JIRENGOD/Digital-Synthesizer-Keyboard-with-Multiple-Voices/docs/images/fig1_design_flow.png

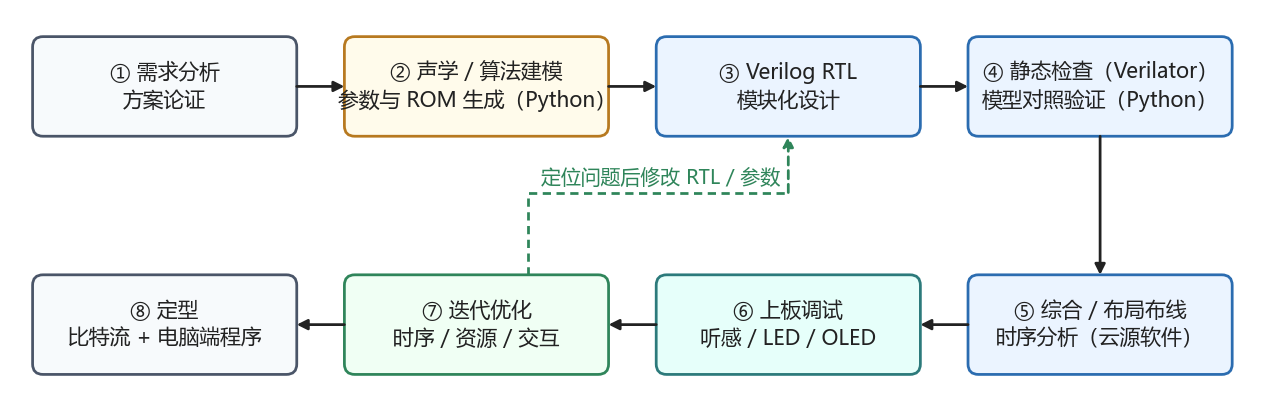
docs/images/fig1_design_flow.png
