JIRENGOD/Digital-Synthesizer-Keyboard-with-Multiple-Voices/docs/images/fig2_hierarchy.png

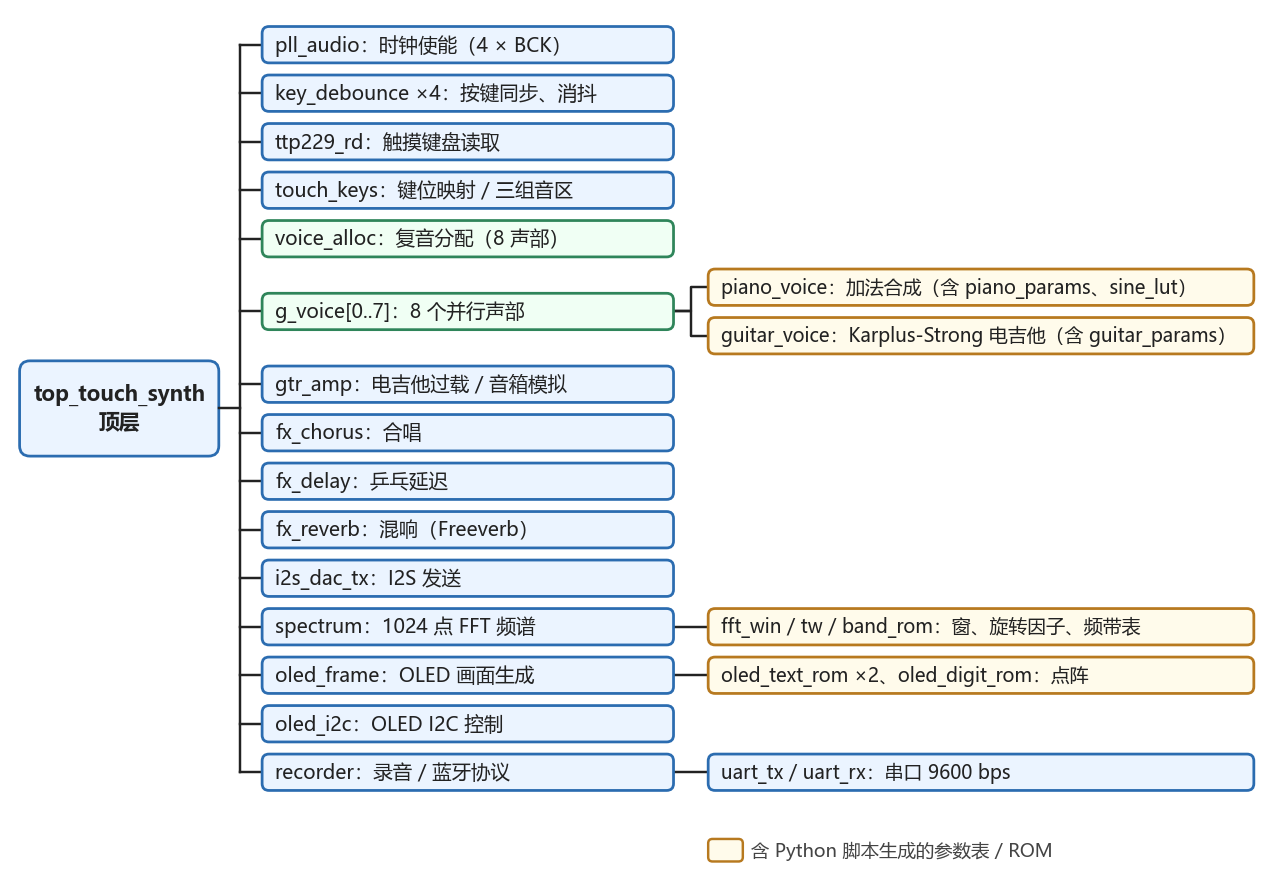
docs/images/fig2_hierarchy.png
