JIRENGOD/Digital-Synthesizer-Keyboard-with-Multiple-Voices/docs/images/fig2_oled.png

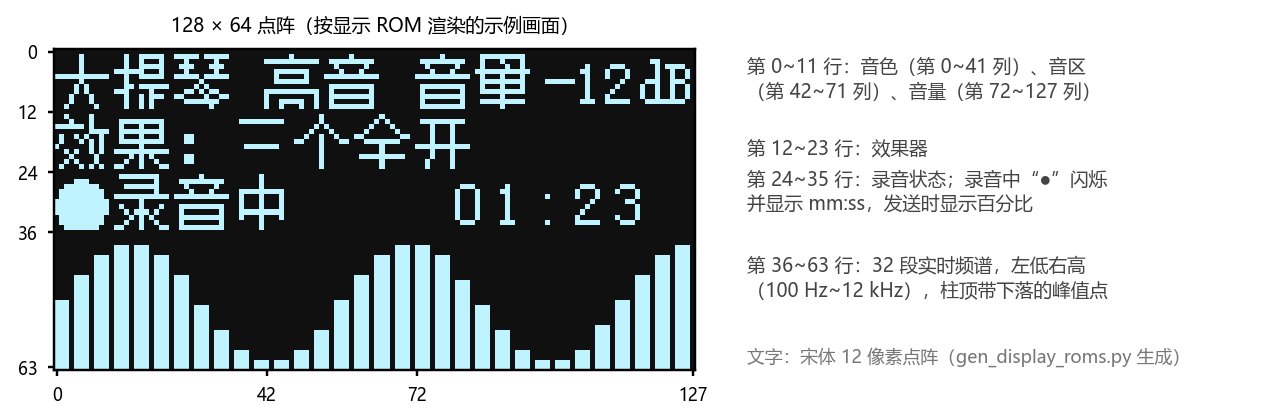
docs/images/fig2_oled.png
