JIRENGOD/Digital-Synthesizer-Keyboard-with-Multiple-Voices/docs/images/fig3_demo_render.png

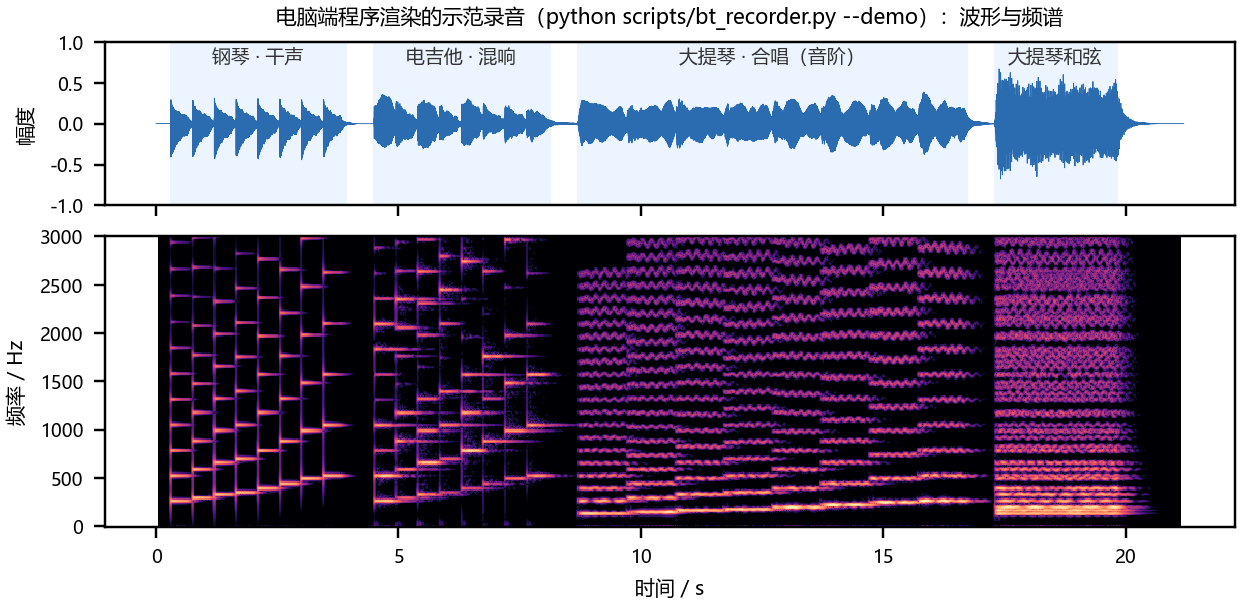
docs/images/fig3_demo_render.png
