JIRENGOD/Digital-Synthesizer-Keyboard-with-Multiple-Voices/src/piano/piano_params.v

`timescale 1ns/1ps
// =============================================================================
// piano_params.v —— 加法合成音色参数表：音色 0 = 钢琴（A2 ~ F#6），音色 1 = 大提琴（A1 ~ F#5）
// 由 scripts/gen_piano_params.py 自动生成。不要手改下面的数字：改音色请改脚本顶部的“音色旋钮”，
// 然后重新生成。
// -----------------------------------------------------------------------------
// 音序号 note = 0 ~ 45：钢琴 MIDI 45 + note，大提琴 MIDI 33 + note（低一个八度）
// 每个振荡器（一个正弦分音）的参数，piano_voice.v 每个采样依次计算全部振荡器再相加：
//   base  基音相位增量 = round(基音频率 × 2^32 / 48828.1)，按 {音色, 音} 查表
//   ratio 频率倍数（Q5.20，噪声为 0），按 {音色, 振荡器} 查表；相位增量 = base × ratio
//   peak  包络峰值（24 位，满幅 16777215）；每个音所有振荡器的 peak 之和 = 0.9 满幅，不会削顶
//   att   起音：每个采样包络加 att，直到 peak（线性上升）
//   m1    衰减 1：每 m1 个采样，包络 ×(1-1/256)，即 -0.0339 dB
//   knee  包络低于 knee 后切换到衰减 2
//   m2    衰减 2：同 m1
//   抬键（note_off）后改用 m_rel 衰减
// peak、att、knee：钢琴按振荡器查表（与音高无关）；大提琴按 {音, 振荡器} 查表（随音高变，放在 BSRAM 里）
// 除 m_rel、noise_lpf 外，所有输出都晚 1 拍（输出寄存）。
//
// 音色 0：钢琴（抬键 118.6 dB/s，噪声低通 >>2）
//  序号 振荡器        频率倍数  电平(dB)  起音(ms)  衰减1(dB/s)  拐点(dB)  衰减2(dB/s)
//    0  第1分音          1.0000      0.0     2.00        12.0       -12         3.4
//    1  第2分音          2.0010     -1.0     1.41        22.4       -12         6.4
//    2  第3分音          3.0042     -4.0     1.15        32.5       -12         9.2
//    3  第4分音          4.0105     -6.0     1.00        41.5       -12        11.9
//    4  第5分音          5.0209     -8.0     0.89        51.9       -12        14.6
//    5  第6分音          6.0366    -10.0     0.82        59.3       -12        17.1
//    6  第7分音          7.0585    -13.0     0.76        69.2       -12        19.8
//    7  第8分音          8.0877    -24.0     0.71        79.0       -12        22.1
//    8  第9分音          9.1251    -16.0     0.67        87.4       -12        24.8
//    9  第10分音        10.1717    -18.0     0.63        97.6       -12        27.2
//   10  第11分音        11.2285    -21.0     0.60       103.7       -12        29.6
//   11  第12分音        12.2965    -23.0     0.58       110.7       -12        31.9
//   12  第13分音        13.3766    -26.0     0.55       118.6       -12        34.6
//   13  第14分音        14.4697    -29.0     0.53       127.7       -12        36.9
//   14  第15分音        15.5767    -32.0     0.52       138.3       -12        39.5
//   15  第16分音        16.6985    -42.0     0.50       150.9       -12        41.5
//   16  第1分音失谐弦    1.0009      0.0     2.00        12.0       -12         3.4
//   17  第2分音失谐弦    2.0029     -1.0     1.41        22.4       -12         6.4
//   18  第3分音失谐弦    3.0070     -4.0     1.15        32.5       -12         9.2
//   19  第4分音失谐弦    4.0142     -6.0     1.00        41.5       -12        11.9
//   20  琴槌噪声           噪声    -18.4     0.50      1659.9       -20       415.0
//
// 音色 1：大提琴（抬键 59.3 dB/s，噪声低通 >>1）（电平是音序号 23 = G#3 的）
//  序号 振荡器        频率倍数  电平(dB)  起音(ms)  衰减1(dB/s)  拐点(dB)  衰减2(dB/s)
//    0  第1谐波          1.0000      0.0    90.00         6.0        -2         0.4
//    1  第2谐波          2.0000     -8.2    73.10         6.0        -2         0.4
//    2  第3谐波          3.0000    -14.4    64.73         6.0        -2         0.4
//    3  第4谐波          4.0000    -19.0    59.38         6.0        -2         0.4
//    4  第5谐波          5.0000    -21.8    55.53         6.0        -2         0.4
//    5  第6谐波          6.0000    -22.7    52.58         6.0        -2         0.4
//    6  第7谐波          7.0000    -22.5    50.20         6.0        -2         0.4
//    7  第8谐波          8.0000    -22.2    48.23         6.0        -2         0.4
//    8  第9谐波          9.0000    -22.2    46.56         6.0        -2         0.4
//    9  第10谐波        10.0000    -22.6    45.11         6.0        -2         0.4
//   10  第11谐波        11.0000    -23.2    43.84         6.0        -2         0.4
//   11  第12谐波        12.0000    -23.9    42.71         6.0        -2         0.4
//   12  第13谐波        13.0000    -24.8    41.69         6.0        -2         0.4
//   13  第14谐波        14.0000    -25.7    40.78         6.0        -2         0.4
//   14  第15谐波        15.0000    -27.2    39.94         6.0        -2         0.4
//   15  第16谐波        16.0000    -29.2    39.17         6.0        -2         0.4
//   16  第17谐波        17.0000    -31.1    38.47         6.0        -2         0.4
//   17  第18谐波        18.0000    -32.8    37.81         6.0        -2         0.4
//   18  第19谐波        19.0000    -34.5    37.21         6.0        -2         0.4
//   19  第20谐波        20.0000    -36.0    36.64         6.0        -2         0.4
//   20  弓毛噪声           噪声    -24.0     8.00        59.3       -12         0.4
// =============================================================================
module piano_params (
    input  wire        clk,
    input  wire        patch,      // 音色：0 = 钢琴，1 = 大提琴
    input  wire [5:0]  note,       // 音序号 0 ~ 45
    input  wire [4:0]  idx,        // 振荡器序号
    output reg  [26:0] base,       // 基音相位增量
    output reg  [24:0] ratio,      // 频率倍数 Q5.20
    output wire [23:0] peak,       // 包络峰值
    output wire [23:0] att,        // 起音每采样增量
    output wire [23:0] knee,       // 衰减 1 -> 衰减 2 的拐点
    output reg  [11:0] m1,         // 衰减 1 周期（采样数）
    output reg  [11:0] m2,         // 衰减 2 周期（采样数）
    output reg         is_noise,   // 1 = 噪声（不查正弦表）
    output reg         is_last,    // 1 = 最后一个振荡器
    output wire [11:0] m_rel,      // 抬键后的衰减周期（组合输出）
    output wire [3:0]  noise_lpf   // 噪声一阶低通的右移位数（组合输出）
);

    assign m_rel     = patch ? 12'd28 : 12'd14;   // 大提琴 59.3 dB/s，钢琴 118.6 dB/s
    assign noise_lpf = patch ? 4'd1 : 4'd2;

    reg        patch_q;
    reg [71:0] pia_q;              // 钢琴 {peak, att, knee}
    reg [71:0] cel_q;              // 大提琴 {peak, att, knee}
    assign {peak, att, knee} = patch_q ? cel_q : pia_q;

    always @(posedge clk) begin
        patch_q <= patch;

        // 基音相位增量：按 {音色, 音序号} 查表
        case ({patch, note})
        {1'b0, 6'd0 }: base <= 27'd9675702;    // 钢琴 A2    110.00 Hz
        {1'b0, 6'd1 }: base <= 27'd10251050;   // 钢琴 A#2   116.54 Hz
        {1'b0, 6'd2 }: base <= 27'd10860609;   // 钢琴 B2    123.47 Hz
        {1'b0, 6'd3 }: base <= 27'd11506414;   // 钢琴 C3    130.81 Hz
        {1'b0, 6'd4 }: base <= 27'd12190621;   // 钢琴 C#3   138.59 Hz
        {1'b0, 6'd5 }: base <= 27'd12915513;   // 钢琴 D3    146.83 Hz
        {1'b0, 6'd6 }: base <= 27'd13683509;   // 钢琴 D#3   155.56 Hz
        {1'b0, 6'd7 }: base <= 27'd14497173;   // 钢琴 E3    164.81 Hz
        {1'b0, 6'd8 }: base <= 27'd15359220;   // 钢琴 F3    174.61 Hz
        {1'b0, 6'd9 }: base <= 27'd16272527;   // 钢琴 F#3   185.00 Hz
        {1'b0, 6'd10}: base <= 27'd17240142;   // 钢琴 G3    196.00 Hz
        {1'b0, 6'd11}: base <= 27'd18265294;   // 钢琴 G#3   207.65 Hz
        {1'b0, 6'd12}: base <= 27'd19351405;   // 钢琴 A3    220.00 Hz
        {1'b0, 6'd13}: base <= 27'd20502099;   // 钢琴 A#3   233.08 Hz
        {1'b0, 6'd14}: base <= 27'd21721217;   // 钢琴 B3    246.94 Hz
        {1'b0, 6'd15}: base <= 27'd23012828;   // 钢琴 C4    261.63 Hz
        {1'b0, 6'd16}: base <= 27'd24381242;   // 钢琴 C#4   277.18 Hz
        {1'b0, 6'd17}: base <= 27'd25831026;   // 钢琴 D4    293.66 Hz
        {1'b0, 6'd18}: base <= 27'd27367019;   // 钢琴 D#4   311.13 Hz
        {1'b0, 6'd19}: base <= 27'd28994347;   // 钢琴 E4    329.63 Hz
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
        {1'b1, 6'd34}: base <= 27'd34480283;   // 大提琴 G4    392.00 Hz
        {1'b1, 6'd35}: base <= 27'd36530588;   // 大提琴 G#4   415.30 Hz
        {1'b1, 6'd36}: base <= 27'd38702809;   // 大提琴 A4    440.00 Hz
        {1'b1, 6'd37}: base <= 27'd41004198;   // 大提琴 A#4   466.16 Hz
        {1'b1, 6'd38}: base <= 27'd43442435;   // 大提琴 B4    493.88 Hz
        {1'b1, 6'd39}: base <= 27'd46025656;   // 大提琴 C5    523.25 Hz
        {1'b1, 6'd40}: base <= 27'd48762484;   // 大提琴 C#5   554.37 Hz
        {1'b1, 6'd41}: base <= 27'd51662052;   // 大提琴 D5    587.33 Hz
        {1'b1, 6'd42}: base <= 27'd54734038;   // 大提琴 D#5   622.25 Hz
        {1'b1, 6'd43}: base <= 27'd57988693;   // 大提琴 E5    659.26 Hz
        {1'b1, 6'd44}: base <= 27'd61436880;   // 大提琴 F5    698.46 Hz
        {1'b1, 6'd45}: base <= 27'd65090107;   // 大提琴 F#5   739.99 Hz
        default: base <= 27'd0;
        endcase

        // 频率倍数、衰减周期、噪声标志：按 {音色, 振荡器序号} 查表
        case ({patch, idx})
        {1'b0, 5'd0 }: begin ratio <= 25'd1048576;  m1 <= 12'd138;  m2 <= 12'd484;  is_noise <= 1'b0; is_last <= 1'b0; end  // 钢琴 第1分音
        {1'b0, 5'd1 }: begin ratio <= 25'd2098252;  m1 <= 12'd74;   m2 <= 12'd259;  is_noise <= 1'b0; is_last <= 1'b0; end  // 钢琴 第2分音
        {1'b0, 5'd2 }: begin ratio <= 25'd3150127;  m1 <= 12'd51;   m2 <= 12'd180;  is_noise <= 1'b0; is_last <= 1'b0; end  // 钢琴 第3分音
        {1'b0, 5'd3 }: begin ratio <= 25'd4205296;  m1 <= 12'd40;   m2 <= 12'd139;  is_noise <= 1'b0; is_last <= 1'b0; end  // 钢琴 第4分音
        {1'b0, 5'd4 }: begin ratio <= 25'd5264846;  m1 <= 12'd32;   m2 <= 12'd114;  is_noise <= 1'b0; is_last <= 1'b0; end  // 钢琴 第5分音
        {1'b0, 5'd5 }: begin ratio <= 25'd6329860;  m1 <= 12'd28;   m2 <= 12'd97;   is_noise <= 1'b0; is_last <= 1'b0; end  // 钢琴 第6分音
        {1'b0, 5'd6 }: begin ratio <= 25'd7401410;  m1 <= 12'd24;   m2 <= 12'd84;   is_noise <= 1'b0; is_last <= 1'b0; end  // 钢琴 第7分音
        {1'b0, 5'd7 }: begin ratio <= 25'd8480556;  m1 <= 12'd21;   m2 <= 12'd75;   is_noise <= 1'b0; is_last <= 1'b0; end  // 钢琴 第8分音
        {1'b0, 5'd8 }: begin ratio <= 25'd9568347;  m1 <= 12'd19;   m2 <= 12'd67;   is_noise <= 1'b0; is_last <= 1'b0; end  // 钢琴 第9分音
        {1'b0, 5'd9 }: begin ratio <= 25'd10665816; m1 <= 12'd17;   m2 <= 12'd61;   is_noise <= 1'b0; is_last <= 1'b0; end  // 钢琴 第10分音
        {1'b0, 5'd10}: begin ratio <= 25'd11773983; m1 <= 12'd16;   m2 <= 12'd56;   is_noise <= 1'b0; is_last <= 1'b0; end  // 钢琴 第11分音
        {1'b0, 5'd11}: begin ratio <= 25'd12893847; m1 <= 12'd15;   m2 <= 12'd52;   is_noise <= 1'b0; is_last <= 1'b0; end  // 钢琴 第12分音
        {1'b0, 5'd12}: begin ratio <= 25'd14026393; m1 <= 12'd14;   m2 <= 12'd48;   is_noise <= 1'b0; is_last <= 1'b0; end  // 钢琴 第13分音
        {1'b0, 5'd13}: begin ratio <= 25'd15172584; m1 <= 12'd13;   m2 <= 12'd45;   is_noise <= 1'b0; is_last <= 1'b0; end  // 钢琴 第14分音
        {1'b0, 5'd14}: begin ratio <= 25'd16333362; m1 <= 12'd12;   m2 <= 12'd42;   is_noise <= 1'b0; is_last <= 1'b0; end  // 钢琴 第15分音
        {1'b0, 5'd15}: begin ratio <= 25'd17509650; m1 <= 12'd11;   m2 <= 12'd40;   is_noise <= 1'b0; is_last <= 1'b0; end  // 钢琴 第16分音
        {1'b0, 5'd16}: begin ratio <= 25'd1049546;  m1 <= 12'd138;  m2 <= 12'd484;  is_noise <= 1'b0; is_last <= 1'b0; end  // 钢琴 第1分音失谐弦
        {1'b0, 5'd17}: begin ratio <= 25'd2100192;  m1 <= 12'd74;   m2 <= 12'd259;  is_noise <= 1'b0; is_last <= 1'b0; end  // 钢琴 第2分音失谐弦
        {1'b0, 5'd18}: begin ratio <= 25'd3153040;  m1 <= 12'd51;   m2 <= 12'd180;  is_noise <= 1'b0; is_last <= 1'b0; end  // 钢琴 第3分音失谐弦
        {1'b0, 5'd19}: begin ratio <= 25'd4209184;  m1 <= 12'd40;   m2 <= 12'd139;  is_noise <= 1'b0; is_last <= 1'b0; end  // 钢琴 第4分音失谐弦
        {1'b0, 5'd20}: begin ratio <= 25'd0;        m1 <= 12'd1;    m2 <= 12'd4;    is_noise <= 1'b1; is_last <= 1'b1; end  // 钢琴 琴槌噪声
        {1'b1, 5'd0 }: begin ratio <= 25'd1048576;  m1 <= 12'd277;  m2 <= 12'd4095; is_noise <= 1'b0; is_last <= 1'b0; end  // 大提琴 第1谐波
        {1'b1, 5'd1 }: begin ratio <= 25'd2097152;  m1 <= 12'd277;  m2 <= 12'd4095; is_noise <= 1'b0; is_last <= 1'b0; end  // 大提琴 第2谐波
        {1'b1, 5'd2 }: begin ratio <= 25'd3145728;  m1 <= 12'd277;  m2 <= 12'd4095; is_noise <= 1'b0; is_last <= 1'b0; end  // 大提琴 第3谐波
        {1'b1, 5'd3 }: begin ratio <= 25'd4194304;  m1 <= 12'd277;  m2 <= 12'd4095; is_noise <= 1'b0; is_last <= 1'b0; end  // 大提琴 第4谐波
        {1'b1, 5'd4 }: begin ratio <= 25'd5242880;  m1 <= 12'd277;  m2 <= 12'd4095; is_noise <= 1'b0; is_last <= 1'b0; end  // 大提琴 第5谐波
        {1'b1, 5'd5 }: begin ratio <= 25'd6291456;  m1 <= 12'd277;  m2 <= 12'd4095; is_noise <= 1'b0; is_last <= 1'b0; end  // 大提琴 第6谐波
        {1'b1, 5'd6 }: begin ratio <= 25'd7340032;  m1 <= 12'd277;  m2 <= 12'd4095; is_noise <= 1'b0; is_last <= 1'b0; end  // 大提琴 第7谐波
        {1'b1, 5'd7 }: begin ratio <= 25'd8388608;  m1 <= 12'd277;  m2 <= 12'd4095; is_noise <= 1'b0; is_last <= 1'b0; end  // 大提琴 第8谐波
        {1'b1, 5'd8 }: begin ratio <= 25'd9437184;  m1 <= 12'd277;  m2 <= 12'd4095; is_noise <= 1'b0; is_last <= 1'b0; end  // 大提琴 第9谐波
        {1'b1, 5'd9 }: begin ratio <= 25'd10485760; m1 <= 12'd277;  m2 <= 12'd4095; is_noise <= 1'b0; is_last <= 1'b0; end  // 大提琴 第10谐波
        {1'b1, 5'd10}: begin ratio <= 25'd11534336; m1 <= 12'd277;  m2 <= 12'd4095; is_noise <= 1'b0; is_last <= 1'b0; end  // 大提琴 第11谐波
        {1'b1, 5'd11}: begin ratio <= 25'd12582912; m1 <= 12'd277;  m2 <= 12'd4095; is_noise <= 1'b0; is_last <= 1'b0; end  // 大提琴 第12谐波
        {1'b1, 5'd12}: begin ratio <= 25'd13631488; m1 <= 12'd277;  m2 <= 12'd4095; is_noise <= 1'b0; is_last <= 1'b0; end  // 大提琴 第13谐波
        {1'b1, 5'd13}: begin ratio <= 25'd14680064; m1 <= 12'd277;  m2 <= 12'd4095; is_noise <= 1'b0; is_last <= 1'b0; end  // 大提琴 第14谐波
        {1'b1, 5'd14}: begin ratio <= 25'd15728640; m1 <= 12'd277;  m2 <= 12'd4095; is_noise <= 1'b0; is_last <= 1'b0; end  // 大提琴 第15谐波
        {1'b1, 5'd15}: begin ratio <= 25'd16777216; m1 <= 12'd277;  m2 <= 12'd4095; is_noise <= 1'b0; is_last <= 1'b0; end  // 大提琴 第16谐波
        {1'b1, 5'd16}: begin ratio <= 25'd17825792; m1 <= 12'd277;  m2 <= 12'd4095; is_noise <= 1'b0; is_last <= 1'b0; end  // 大提琴 第17谐波
        {1'b1, 5'd17}: begin ratio <= 25'd18874368; m1 <= 12'd277;  m2 <= 12'd4095; is_noise <= 1'b0; is_last <= 1'b0; end  // 大提琴 第18谐波
        {1'b1, 5'd18}: begin ratio <= 25'd19922944; m1 <= 12'd277;  m2 <= 12'd4095; is_noise <= 1'b0; is_last <= 1'b0; end  // 大提琴 第19谐波
        {1'b1, 5'd19}: begin ratio <= 25'd20971520; m1 <= 12'd277;  m2 <= 12'd4095; is_noise <= 1'b0; is_last <= 1'b0; end  // 大提琴 第20谐波
        {1'b1, 5'd20}: begin ratio <= 25'd0;        m1 <= 12'd28;   m2 <= 12'd4095; is_noise <= 1'b1; is_last <= 1'b1; end  // 大提琴 弓毛噪声
        default: begin ratio <= 25'd0; m1 <= 12'd1; m2 <= 12'd1; is_noise <= 1'b0; is_last <= 1'b1; end
        endcase

        // 钢琴 {peak, att, knee}：按振荡器序号查表（与音高无关）
        case (idx)
        5'd0 : pia_q <= {24'd2245201, 24'd22991, 24'd563969};  // 第1分音
        5'd1 : pia_q <= {24'd2001037, 24'd28979, 24'd502638};  // 第2分音
        5'd2 : pia_q <= {24'd1416626, 24'd25126, 24'd355840};  // 第3分音
        5'd3 : pia_q <= {24'd1125266, 24'd23046, 24'd282654};  // 第4分音
        5'd4 : pia_q <= {24'd1276901, 24'd29238, 24'd320743};  // 第5分音
        5'd5 : pia_q <= {24'd1014278, 24'd25441, 24'd254775};  // 第6分音
        5'd6 : pia_q <= {24'd718054, 24'd19454, 24'd180367};  // 第7分音
        5'd7 : pia_q <= {24'd202375, 24'd5862, 24'd50834};  // 第8分音
        5'd8 : pia_q <= {24'd508343, 24'd15617, 24'd127690};  // 第9分音
        5'd9 : pia_q <= {24'd403791, 24'd13076, 24'd101428};  // 第10分音
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
        {6'd45, 5'd18}: cel_q <= {24'd13731, 24'd8, 24'd10907};
        {6'd45, 5'd19}: cel_q <= {24'd11777, 24'd7, 24'd9355};
        {6'd45, 5'd20}: cel_q <= {24'd324522, 24'd831, 24'd81516};
        default: cel_q <= 72'd0;
        endcase
    end

endmodule
