JIRENGOD/Digital-Synthesizer-Keyboard-with-Multiple-Voices/src/guitar/guitar_params.v

`timescale 1ns/1ps
// =============================================================================
// guitar_params.v —— 电吉他（Karplus-Strong 拨弦模型）参数表：46 个音 A2 ~ F#6
// 由 scripts/gen_guitar_params.py 自动生成。不要手改下面的数字：改音色请改脚本顶部的“音色旋钮”。
// -----------------------------------------------------------------------------
//   m     延迟线整数延迟 M（采样）；环路总延迟 = M + 0.5（两点平均）+ d（全通）= Fs / f0
//   c     一阶全通系数 × 32768（有符号），实现小数延迟 d
//   p     拾音器抽头：输出 = v[n] - v[n-p]
//   g_sus 按住时每圈环路增益 × 65536（基音衰减 6 dB/s）
//   g_rel 抬键后每圈环路增益 × 65536（衰减 150 dB/s）
//
// 序号 音名   基音(Hz)   总延迟     M      d       c      P   音高误差(音分)
//   0  A2     110.00   443.892   442   1.392   -5371   89    -0.000
//   1  A#2    116.54   418.978   417   1.478   -6324   84    +0.000
//   2  B2     123.47   395.463   394   0.963     620   79    -0.000
//   3  C3     130.81   373.267   372   0.767    4316   75    -0.000
//   4  C#3    138.59   352.317   351   0.817    3293   70    -0.000
//   5  D3     146.83   332.543   331   1.043    -694   67    +0.000
//   6  D#3    155.56   313.879   312   1.379   -5222   63    -0.000
//   7  E3     164.81   296.262   295   0.762    4418   59    +0.000
//   8  F3     174.61   279.634   278   1.134   -2064   56    +0.000
//   9  F#3    185.00   263.940   262   1.440   -5907   53    +0.000
//  10  G3     196.00   249.126   248   0.626    7538   50    +0.000
//  11  G#3    207.65   235.144   234   0.644    7106   47    +0.000
//  12  A3     220.00   221.946   220   1.446   -5976   44    +0.000
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
        6'd16: begin m = 10'd175; c = 16'sd6744;   p = 10'd35; g_sus = 16'd65383;  g_rel = 16'd61587;  end  // C#4
        6'd17: begin m = 10'd165; c = 16'sd4224;   p = 10'd33; g_sus = 16'd65394;  g_rel = 16'd61804;  end  // D4
        6'd18: begin m = 10'd155; c = -16'sd5906;  p = 10'd31; g_sus = 16'd65404;  g_rel = 16'd62010;  end  // D#4
        6'd19: begin m = 10'd147; c = 16'sd7410;   p = 10'd30; g_sus = 16'd65414;  g_rel = 16'd62205;  end  // E4
        6'd20: begin m = 10'd138; c = -16'sd4488;  p = 10'd28; g_sus = 16'd65423;  g_rel = 16'd62390;  end  // F4
        6'd21: begin m = 10'd130; c = -16'sd6238;  p = 10'd26; g_sus = 16'd65432;  g_rel = 16'd62565;  end  // F#4
        6'd22: begin m = 10'd123; c = -16'sd1001;  p = 10'd25; g_sus = 16'd65441;  g_rel = 16'd62731;  end  // G4
        6'd23: begin m = 10'd116; c = -16'sd1136;  p = 10'd24; g_sus = 16'd65450;  g_rel = 16'd62889;  end  // G#4
        6'd24: begin m = 10'd109; c = -16'sd6272;  p = 10'd22; g_sus = 16'd65459;  g_rel = 16'd63039;  end  // A4
        6'd25: begin m = 10'd103; c = -16'sd3573;  p = 10'd21; g_sus = 16'd65468;  g_rel = 16'd63181;  end  // A#4
        6'd26: begin m = 10'd97;  c = -16'sd5070;  p = 10'd20; g_sus = 16'd65477;  g_rel = 16'd63316;  end  // B4
        6'd27: begin m = 10'd92;  c = 16'sd3306;   p = 10'd19; g_sus = 16'd65487;  g_rel = 16'd63444;  end  // C5
        6'd28: begin m = 10'd87;  c = 16'sd8732;   p = 10'd18; g_sus = 16'd65496;  g_rel = 16'd63566;  end  // C#5
        6'd29: begin m = 10'd82;  c = 16'sd7299;   p = 10'd17; g_sus = 16'd65506;  g_rel = 16'd63683;  end  // D5
        6'd30: begin m = 10'd77;  c = 16'sd503;    p = 10'd16; g_sus = 16'd65516;  g_rel = 16'd63793;  end  // D#5
        6'd31: begin m = 10'd73;  c = 16'sd9098;   p = 10'd15; g_sus = 16'd65526;  g_rel = 16'd63899;  end  // E5
        6'd32: begin m = 10'd68;  c = -16'sd5570;  p = 10'd14; g_sus = 16'd65535;  g_rel = 16'd64000;  end  // F5
        6'd33: begin m = 10'd64;  c = -16'sd6409;  p = 10'd13; g_sus = 16'd65535;  g_rel = 16'd64097;  end  // F#5
        6'd34: begin m = 10'd61;  c = 16'sd4024;   p = 10'd12; g_sus = 16'd65535;  g_rel = 16'd64190;  end  // G5
        6'd35: begin m = 10'd57;  c = -16'sd4108;  p = 10'd12; g_sus = 16'd65535;  g_rel = 16'd64279;  end  // G#5
        6'd36: begin m = 10'd54;  c = 16'sd223;    p = 10'd11; g_sus = 16'd65535;  g_rel = 16'd64366;  end  // A5
        6'd37: begin m = 10'd51;  c = 16'sd2240;   p = 10'd10; g_sus = 16'd65535;  g_rel = 16'd64449;  end  // A#5
        6'd38: begin m = 10'd48;  c = 16'sd1141;   p = 10'd10; g_sus = 16'd65535;  g_rel = 16'd64530;  end  // B5
        6'd39: begin m = 10'd45;  c = -16'sd2413;  p = 10'd9;  g_sus = 16'd65535;  g_rel = 16'd64610;  end  // C6
        6'd40: begin m = 10'd43;  c = 16'sd9815;   p = 10'd9;  g_sus = 16'd65535;  g_rel = 16'd64688;  end  // C#6
        6'd41: begin m = 10'd40;  c = -16'sd1081;  p = 10'd8;  g_sus = 16'd65535;  g_rel = 16'd64764;  end  // D6
        6'd42: begin m = 10'd38;  c = 16'sd5023;   p = 10'd8;  g_sus = 16'd65535;  g_rel = 16'd64841;  end  // D#6
        6'd43: begin m = 10'd36;  c = 16'sd10013;  p = 10'd7;  g_sus = 16'd65535;  g_rel = 16'd64917;  end  // E6
        6'd44: begin m = 10'd33;  c = -16'sd6113;  p = 10'd7;  g_sus = 16'd65535;  g_rel = 16'd64993;  end  // F6
        6'd45: begin m = 10'd31;  c = -16'sd6533;  p = 10'd7;  g_sus = 16'd65535;  g_rel = 16'd65071;  end  // F#6
        default: begin m = 10'd185; c = 16'sd0; p = 10'd37; g_sus = 16'd65000; g_rel = 16'd60000; end
        endcase
    end

endmodule
