JIRENGOD/Digital-Synthesizer-Keyboard-with-Multiple-Voices/src/oled/oled_text_rom.v

`timescale 1ns/1ps
// =============================================================================
// oled_text_rom.v —— OLED 文字点阵条（宋体 12 像素），由 scripts/gen_display_roms.py 自动生成，不要手改
// -----------------------------------------------------------------------------
// 地址 = {条号[4:0], 列[6:0]}；数据 = 这一列的 12 个点（第 0 位 = 最上面一行）。读数据晚 1 拍。
// 条号：
//    0  钢琴
//    1  电吉他
//    2  大提琴
//    3  低音
//    4  中音
//    5  高音
//    6  音量 0dB
//    7  音量 -6dB
//    8  音量 -12dB
//    9  音量 -18dB
//   10  效果：干声
//   11  效果：混响
//   12  效果：延迟
//   13  效果：合唱
//   14  效果：三个全开
//   15  录音：按key2开始
//   16  ●录音中
//   17  已录好，等待电脑连接
//   18  蓝牙发送
//   19  已发送 时长
// =============================================================================
module oled_text_rom (
    input  wire        clk,
    input  wire [11:0] addr,
    output reg  [11:0] data
);

    always @(posedge clk) begin
        case (addr)
        12'd0: data <= 12'h128;
        12'd1: data <= 12'hFE6;
        12'd2: data <= 12'h924;
        12'd4: data <= 12'hFFC;
        12'd5: data <= 12'h224;
        12'd6: data <= 12'h144;
        12'd7: data <= 12'h084;
        12'd8: data <= 12'h144;
        12'd9: data <= 12'h224;
        12'd10: data <= 12'hFFC;
        12'd12: data <= 12'h222;
        12'd13: data <= 12'h22A;
        12'd14: data <= 12'h53E;
        12'd15: data <= 12'h52A;
        12'd16: data <= 12'h4A2;
        12'd17: data <= 12'h540;
        12'd18: data <= 12'h6A2;
        12'd19: data <= 12'hD2A;
        12'd20: data <= 12'h53E;
        12'd21: data <= 12'h22A;
        12'd22: data <= 12'h222;
        12'd128: data <= 12'h7F8;
        12'd129: data <= 12'h248;
        12'd130: data <= 12'h248;
        12'd131: data <= 12'h248;
        12'd132: data <= 12'hFFE;
        12'd133: data <= 12'h248;
        12'd134: data <= 12'h248;
        12'd135: data <= 12'h248;
        12'd136: data <= 12'h3F8;
        12'd138: data <= 12'hC00;
        12'd140: data <= 12'h008;
        12'd141: data <= 12'hF48;
        12'd142: data <= 12'h948;
        12'd143: data <= 12'h948;
        12'd144: data <= 12'h948;
        12'd145: data <= 12'h97E;
        12'd146: data <= 12'h948;
        12'd147: data <= 12'h948;
        12'd148: data <= 12'h948;
        12'd149: data <= 12'hF48;
        12'd150: data <= 12'h008;
        12'd152: data <= 12'h040;
        12'd153: data <= 12'h020;
        12'd154: data <= 12'hFF8;
        12'd155: data <= 12'h006;
        12'd156: data <= 12'h040;
        12'd157: data <= 12'hFF8;
        12'd158: data <= 12'h020;
        12'd159: data <= 12'h3FE;
        12'd160: data <= 12'h010;
        12'd161: data <= 12'h108;
        12'd162: data <= 12'hDF8;
        12'd256: data <= 12'h020;
        12'd257: data <= 12'h020;
        12'd258: data <= 12'h820;
        12'd259: data <= 12'h620;
        12'd260: data <= 12'h1A0;
        12'd261: data <= 12'h07E;
        12'd262: data <= 12'h1A0;
        12'd263: data <= 12'h620;
        12'd264: data <= 12'h820;
        12'd265: data <= 12'h020;
        12'd266: data <= 12'h020;
        12'd268: data <= 12'h110;
        12'd269: data <= 12'h110;
        12'd270: data <= 12'hFFE;
        12'd271: data <= 12'h090;
        12'd272: data <= 12'h010;
        12'd273: data <= 12'hEBE;
        12'd274: data <= 12'h0AA;
        12'd275: data <= 12'hFAA;
        12'd276: data <= 12'h2AA;
        12'd277: data <= 12'h2BE;
        12'd278: data <= 12'h080;
        12'd280: data <= 12'h222;
        12'd281: data <= 12'h22A;
        12'd282: data <= 12'h53E;
        12'd283: data <= 12'h52A;
        12'd284: data <= 12'h4A2;
        12'd285: data <= 12'h540;
        12'd286: data <= 12'h6A2;
        12'd287: data <= 12'hD2A;
        12'd288: data <= 12'h53E;
        12'd289: data <= 12'h22A;
        12'd290: data <= 12'h222;
        12'd426: data <= 12'h040;
        12'd427: data <= 12'h020;
        12'd428: data <= 12'hFF8;
        12'd429: data <= 12'h006;
        12'd430: data <= 12'hFFC;
        12'd431: data <= 12'h444;
        12'd432: data <= 12'hA44;
        12'd433: data <= 12'h1FC;
        12'd434: data <= 12'h642;
        12'd435: data <= 12'h842;
        12'd436: data <= 12'hE40;
        12'd438: data <= 12'h020;
        12'd439: data <= 12'hFA4;
        12'd440: data <= 12'hAAC;
        12'd441: data <= 12'hAB4;
        12'd442: data <= 12'hAA4;
        12'd443: data <= 12'hAA6;
        12'd444: data <= 12'hAA4;
        12'd445: data <= 12'hAB4;
        12'd446: data <= 12'hAAC;
        12'd447: data <= 12'hFA4;
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
        12'd2433: data <= 12'hFE4;
        12'd2434: data <= 12'h084;
        12'd2435: data <= 12'h084;
        12'd2436: data <= 12'h084;
        12'd2437: data <= 12'h084;
        12'd2438: data <= 12'h084;
        12'd2439: data <= 12'h084;
        12'd2440: data <= 12'h084;
        12'd2441: data <= 12'h0FC;
        12'd2442: data <= 12'hC00;
        12'd2444: data <= 12'h81C;
        12'd2445: data <= 12'h410;
        12'd2446: data <= 12'h310;
        12'd2447: data <= 12'h0F0;
        12'd2448: data <= 12'h99E;
        12'd2449: data <= 12'hA90;
        12'd2450: data <= 12'h490;
        12'd2451: data <= 12'hA92;
        12'd2452: data <= 12'h994;
        12'd2453: data <= 12'h010;
        12'd2454: data <= 12'h010;
        12'd2456: data <= 12'h022;
        12'd2457: data <= 12'hFE4;
        12'd2458: data <= 12'h080;
        12'd2459: data <= 12'h890;
        12'd2460: data <= 12'h492;
        12'd2461: data <= 12'h294;
        12'd2462: data <= 12'h1F0;
        12'd2463: data <= 12'h294;
        12'd2464: data <= 12'h492;
        12'd2465: data <= 12'h890;
        12'd2466: data <= 12'h080;
        12'd2474: data <= 12'hFFC;
        12'd2475: data <= 12'h444;
        12'd2476: data <= 12'h444;
        12'd2477: data <= 12'hFFC;
        12'd2479: data <= 12'h010;
        12'd2480: data <= 12'h090;
        12'd2481: data <= 12'h310;
        12'd2482: data <= 12'h010;
        12'd2483: data <= 12'hFFE;
        12'd2484: data <= 12'h010;
        12'd2486: data <= 12'h040;
        12'd2487: data <= 12'h040;
        12'd2488: data <= 12'h040;
        12'd2489: data <= 12'hFFE;
        12'd2490: data <= 12'h850;
        12'd2491: data <= 12'h450;
        12'd2492: data <= 12'h1C8;
        12'd2493: data <= 12'h248;
        12'd2494: data <= 12'h444;
        12'd2495: data <= 12'h844;
        12'd2496: data <= 12'h840;
        default: data <= 12'h000;
        endcase
    end

endmodule
