JIRENGOD/Digital-Synthesizer-Keyboard-with-Multiple-Voices/src/spectrum/fft_roms.v

`timescale 1ns/1ps
// =============================================================================
// fft_roms.v —— 1024 点 FFT 用的只读表，由 scripts/gen_display_roms.py 自动生成，不要手改
//   fft_win_rom  汉宁窗 w[n] = 65535 × (1 - cos(2πn/1024)) / 2，无符号
//   fft_tw_rom   旋转因子 W^k = cos(2πk/1024) - j·sin(2πk/1024)，{实部, 虚部} 各 16 位有符号（×32767）
//   fft_band_rom 频点 k（k × 47.68 Hz）属于第几根频谱柱，63 = 不显示
// 频谱柱（32 根，100 ~ 12000 Hz 按对数均分；低频段每根至少 1 个频点）：
//   柱  0：频点   2 ~   2（     95 ~     143 Hz）
//   柱  1：频点   3 ~   3（    143 ~     191 Hz）
//   柱  2：频点   4 ~   4（    191 ~     238 Hz）
//   柱  3：频点   5 ~   5（    238 ~     286 Hz）
//   柱  4：频点   6 ~   6（    286 ~     334 Hz）
//   柱  5：频点   7 ~   7（    334 ~     381 Hz）
//   柱  6：频点   8 ~   8（    381 ~     429 Hz）
//   柱  7：频点   9 ~   9（    429 ~     477 Hz）
//   柱  8：频点  10 ~  10（    477 ~     525 Hz）
//   柱  9：频点  11 ~  11（    525 ~     572 Hz）
//   柱 10：频点  12 ~  12（    572 ~     620 Hz）
//   柱 11：频点  13 ~  13（    620 ~     668 Hz）
//   柱 12：频点  14 ~  14（    668 ~     715 Hz）
//   柱 13：频点  15 ~  16（    715 ~     811 Hz）
//   柱 14：频点  17 ~  19（    811 ~     954 Hz）
//   柱 15：频点  20 ~  22（    954 ~    1097 Hz）
//   柱 16：频点  23 ~  26（   1097 ~    1287 Hz）
//   柱 17：频点  27 ~  30（   1287 ~    1478 Hz）
//   柱 18：频点  31 ~  35（   1478 ~    1717 Hz）
//   柱 19：频点  36 ~  41（   1717 ~    2003 Hz）
//   柱 20：频点  42 ~  48（   2003 ~    2337 Hz）
//   柱 21：频点  49 ~  55（   2337 ~    2670 Hz）
//   柱 22：频点  56 ~  64（   2670 ~    3099 Hz）
//   柱 23：频点  65 ~  75（   3099 ~    3624 Hz）
//   柱 24：频点  76 ~  87（   3624 ~    4196 Hz）
//   柱 25：频点  88 ~ 102（   4196 ~    4911 Hz）
//   柱 26：频点 103 ~ 118（   4911 ~    5674 Hz）
//   柱 27：频点 119 ~ 137（   5674 ~    6580 Hz）
//   柱 28：频点 138 ~ 160（   6580 ~    7677 Hz）
//   柱 29：频点 161 ~ 186（   7677 ~    8917 Hz）
//   柱 30：频点 187 ~ 216（   8917 ~   10347 Hz）
//   柱 31：频点 217 ~ 251（  10347 ~   12016 Hz）
// 三个表都是读数据晚 1 拍（输出寄存）。
// =============================================================================
module fft_win_rom (
    input  wire        clk,
    input  wire [9:0]  addr,
    output reg  [15:0] data
);
    always @(posedge clk) begin
        case (addr)
        10'd0: data <= 16'd0;
        10'd1: data <= 16'd1;
        10'd2: data <= 16'd2;
        10'd3: data <= 16'd6;
        10'd4: data <= 16'd10;
        10'd5: data <= 16'd15;
        10'd6: data <= 16'd22;
        10'd7: data <= 16'd30;
        10'd8: data <= 16'd39;
        10'd9: data <= 16'd50;
        10'd10: data <= 16'd62;
        10'd11: data <= 16'd75;
        10'd12: data <= 16'd89;
        10'd13: data <= 16'd104;
        10'd14: data <= 16'd121;
        10'd15: data <= 16'd139;
        10'd16: data <= 16'd158;
        10'd17: data <= 16'd178;
        10'd18: data <= 16'd200;
        10'd19: data <= 16'd222;
        10'd20: data <= 16'd246;
        10'd21: data <= 16'd272;
        10'd22: data <= 16'd298;
        10'd23: data <= 16'd326;
        10'd24: data <= 16'd355;
        10'd25: data <= 16'd385;
        10'd26: data <= 16'd416;
        10'd27: data <= 16'd449;
        10'd28: data <= 16'd482;
        10'd29: data <= 16'd517;
        10'd30: data <= 16'd554;
        10'd31: data <= 16'd591;
        10'd32: data <= 16'd630;
        10'd33: data <= 16'd669;
        10'd34: data <= 16'd710;
        10'd35: data <= 16'd753;
        10'd36: data <= 16'd796;
        10'd37: data <= 16'd841;
        10'd38: data <= 16'd887;
        10'd39: data <= 16'd934;
        10'd40: data <= 16'd982;
        10'd41: data <= 16'd1031;
        10'd42: data <= 16'd1082;
        10'd43: data <= 16'd1134;
        10'd44: data <= 16'd1187;
        10'd45: data <= 16'd1241;
        10'd46: data <= 16'd1297;
        10'd47: data <= 16'd1353;
        10'd48: data <= 16'd1411;
        10'd49: data <= 16'd1470;
        10'd50: data <= 16'd1530;
        10'd51: data <= 16'd1591;
        10'd52: data <= 16'd1654;
        10'd53: data <= 16'd1717;
        10'd54: data <= 16'd1782;
        10'd55: data <= 16'd1848;
        10'd56: data <= 16'd1915;
        10'd57: data <= 16'd1984;
        10'd58: data <= 16'd2053;
        10'd59: data <= 16'd2124;
        10'd60: data <= 16'd2196;
        10'd61: data <= 16'd2269;
        10'd62: data <= 16'd2343;
        10'd63: data <= 16'd2418;
        10'd64: data <= 16'd2494;
        10'd65: data <= 16'd2572;
        10'd66: data <= 16'd2650;
        10'd67: data <= 16'd2730;
        10'd68: data <= 16'd2811;
        10'd69: data <= 16'd2893;
        10'd70: data <= 16'd2976;
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
        10'd1018: data <= 16'd22;
        10'd1019: data <= 16'd15;
        10'd1020: data <= 16'd10;
        10'd1021: data <= 16'd6;
        10'd1022: data <= 16'd2;
        10'd1023: data <= 16'd1;
        default: data <= 16'd0;
        endcase
    end
endmodule

module fft_tw_rom (
    input  wire        clk,
    input  wire [8:0]  addr,
    output reg  [31:0] data
);
    always @(posedge clk) begin
        case (addr)
        9'd0: data <= 32'h7FFF0000;
        9'd1: data <= 32'h7FFEFF37;
        9'd2: data <= 32'h7FFDFE6E;
        9'd3: data <= 32'h7FF9FDA5;
        9'd4: data <= 32'h7FF5FCDC;
        9'd5: data <= 32'h7FF0FC13;
        9'd6: data <= 32'h7FE9FB4A;
        9'd7: data <= 32'h7FE1FA81;
        9'd8: data <= 32'h7FD8F9B8;
        9'd9: data <= 32'h7FCDF8EF;
        9'd10: data <= 32'h7FC1F827;
        9'd11: data <= 32'h7FB4F75E;
        9'd12: data <= 32'h7FA6F696;
        9'd13: data <= 32'h7F97F5CD;
        9'd14: data <= 32'h7F86F505;
        9'd15: data <= 32'h7F74F43C;
        9'd16: data <= 32'h7F61F374;
        9'd17: data <= 32'h7F4DF2AC;
        9'd18: data <= 32'h7F37F1E4;
        9'd19: data <= 32'h7F21F11D;
        9'd20: data <= 32'h7F09F055;
        9'd21: data <= 32'h7EEFEF8E;
        9'd22: data <= 32'h7ED5EEC6;
        9'd23: data <= 32'h7EB9EDFF;
        9'd24: data <= 32'h7E9CED38;
        9'd25: data <= 32'h7E7EEC71;
        9'd26: data <= 32'h7E5FEBAB;
        9'd27: data <= 32'h7E3EEAE4;
        9'd28: data <= 32'h7E1DEA1E;
        9'd29: data <= 32'h7DFAE958;
        9'd30: data <= 32'h7DD5E892;
        9'd31: data <= 32'h7DB0E7CD;
        9'd32: data <= 32'h7D89E707;
        9'd33: data <= 32'h7D62E642;
        9'd34: data <= 32'h7D39E57E;
        9'd35: data <= 32'h7D0EE4B9;
        9'd36: data <= 32'h7CE3E3F5;
        9'd37: data <= 32'h7CB6E331;
        9'd38: data <= 32'h7C88E26D;
        9'd39: data <= 32'h7C59E1A9;
        9'd40: data <= 32'h7C29E0E6;
        9'd41: data <= 32'h7BF8E023;
        9'd42: data <= 32'h7BC5DF61;
        9'd43: data <= 32'h7B91DE9F;
        9'd44: data <= 32'h7B5CDDDD;
        9'd45: data <= 32'h7B26DD1B;
        9'd46: data <= 32'h7AEEDC5A;
        9'd47: data <= 32'h7AB6DB99;
        9'd48: data <= 32'h7A7CDAD8;
        9'd49: data <= 32'h7A41DA18;
        9'd50: data <= 32'h7A05D958;
        9'd51: data <= 32'h79C8D899;
        9'd52: data <= 32'h7989D7DA;
        9'd53: data <= 32'h794AD71B;
        9'd54: data <= 32'h7909D65D;
        9'd55: data <= 32'h78C7D59F;
        9'd56: data <= 32'h7884D4E1;
        9'd57: data <= 32'h783FD424;
        9'd58: data <= 32'h77FAD367;
        9'd59: data <= 32'h77B3D2AB;
        9'd60: data <= 32'h776BD1EF;
        9'd61: data <= 32'h7722D134;
        9'd62: data <= 32'h76D8D079;
        9'd63: data <= 32'h768DCFBF;
        9'd64: data <= 32'h7641CF05;
        9'd65: data <= 32'h75F3CE4B;
        9'd66: data <= 32'h75A5CD92;
        9'd67: data <= 32'h7555CCDA;
        9'd68: data <= 32'h7504CC21;
        9'd69: data <= 32'h74B2CB6A;
        9'd70: data <= 32'h745FCAB3;
        9'd71: data <= 32'h740AC9FC;
        9'd72: data <= 32'h73B5C946;
        9'd73: data <= 32'h735EC891;
        9'd74: data <= 32'h7307C7DC;
        9'd75: data <= 32'h72AEC727;
        9'd76: data <= 32'h7254C674;
        9'd77: data <= 32'h71F9C5C0;
        9'd78: data <= 32'h719DC50E;
        9'd79: data <= 32'h7140C45B;
        9'd80: data <= 32'h70E2C3AA;
        9'd81: data <= 32'h7083C2F9;
        9'd82: data <= 32'h7022C248;
        9'd83: data <= 32'h6FC1C198;
        9'd84: data <= 32'h6F5EC0E9;
        9'd85: data <= 32'h6EFBC03B;
        9'd86: data <= 32'h6E96BF8D;
        9'd87: data <= 32'h6E30BEDF;
        9'd88: data <= 32'h6DC9BE32;
        9'd89: data <= 32'h6D61BD86;
        9'd90: data <= 32'h6CF8BCDB;
        9'd91: data <= 32'h6C8EBC30;
        9'd92: data <= 32'h6C23BB86;
        9'd93: data <= 32'h6BB7BADC;
        9'd94: data <= 32'h6B4ABA33;
        9'd95: data <= 32'h6ADCB98B;
        9'd96: data <= 32'h6A6DB8E4;
        9'd97: data <= 32'h69FDB83D;
        9'd98: data <= 32'h698BB797;
        9'd99: data <= 32'h6919B6F1;
        9'd100: data <= 32'h68A6B64C;
        9'd101: data <= 32'h6832B5A8;
        9'd102: data <= 32'h67BCB505;
        9'd103: data <= 32'h6746B463;
        9'd104: data <= 32'h66CFB3C1;
        9'd105: data <= 32'h6656B320;
        9'd106: data <= 32'h65DDB27F;
        9'd107: data <= 32'h6563B1E0;
        9'd108: data <= 32'h64E8B141;
        9'd109: data <= 32'h646CB0A3;
        9'd110: data <= 32'h63EEB005;
        9'd111: data <= 32'h6370AF69;
        9'd112: data <= 32'h62F1AECD;
        9'd113: data <= 32'h6271AE32;
        9'd114: data <= 32'h61F0AD98;
        9'd115: data <= 32'h616EACFE;
        9'd116: data <= 32'h60EBAC65;
        9'd117: data <= 32'h6068ABCE;
        9'd118: data <= 32'h5FE3AB37;
        9'd119: data <= 32'h5F5DAAA0;
        9'd120: data <= 32'h5ED7AA0B;
        9'd121: data <= 32'h5E4FA976;
        9'd122: data <= 32'h5DC7A8E3;
        9'd123: data <= 32'h5D3EA850;
        9'd124: data <= 32'h5CB3A7BE;
        9'd125: data <= 32'h5C28A72D;
        9'd126: data <= 32'h5B9CA69C;
        9'd127: data <= 32'h5B0FA60D;
        9'd128: data <= 32'h5A82A57E;
        9'd129: data <= 32'h59F3A4F1;
        9'd130: data <= 32'h5964A464;
        9'd131: data <= 32'h58D3A3D8;
        9'd132: data <= 32'h5842A34D;
        9'd133: data <= 32'h57B0A2C2;
        9'd134: data <= 32'h571DA239;
        9'd135: data <= 32'h568AA1B1;
        9'd136: data <= 32'h55F5A129;
        9'd137: data <= 32'h5560A0A3;
        9'd138: data <= 32'h54C9A01D;
        9'd139: data <= 32'h54329F98;
        9'd140: data <= 32'h539B9F15;
        9'd141: data <= 32'h53029E92;
        9'd142: data <= 32'h52689E10;
        9'd143: data <= 32'h51CE9D8F;
        9'd144: data <= 32'h51339D0F;
        9'd145: data <= 32'h50979C90;
        9'd146: data <= 32'h4FFB9C12;
        9'd147: data <= 32'h4F5D9B94;
        9'd148: data <= 32'h4EBF9B18;
        9'd149: data <= 32'h4E209A9D;
        9'd150: data <= 32'h4D819A23;
        9'd151: data <= 32'h4CE099AA;
        9'd152: data <= 32'h4C3F9931;
        9'd153: data <= 32'h4B9D98BA;
        9'd154: data <= 32'h4AFB9844;
        9'd155: data <= 32'h4A5897CE;
        9'd156: data <= 32'h49B4975A;
        9'd157: data <= 32'h490F96E7;
        9'd158: data <= 32'h48699675;
        9'd159: data <= 32'h47C39603;
        9'd160: data <= 32'h471C9593;
        9'd161: data <= 32'h46759524;
        9'd162: data <= 32'h45CD94B6;
        9'd163: data <= 32'h45249449;
        9'd164: data <= 32'h447A93DD;
        9'd165: data <= 32'h43D09372;
        9'd166: data <= 32'h43259308;
        9'd167: data <= 32'h427A929F;
        9'd168: data <= 32'h41CE9237;
        9'd169: data <= 32'h412191D0;
        9'd170: data <= 32'h4073916A;
        9'd171: data <= 32'h3FC59105;
        9'd172: data <= 32'h3F1790A2;
        9'd173: data <= 32'h3E68903F;
        9'd174: data <= 32'h3DB88FDE;
        9'd175: data <= 32'h3D078F7D;
        9'd176: data <= 32'h3C568F1E;
        9'd177: data <= 32'h3BA58EC0;
        9'd178: data <= 32'h3AF28E63;
        9'd179: data <= 32'h3A408E07;
        9'd180: data <= 32'h398C8DAC;
        9'd181: data <= 32'h38D98D52;
        9'd182: data <= 32'h38248CF9;
        9'd183: data <= 32'h376F8CA2;
        9'd184: data <= 32'h36BA8C4B;
        9'd185: data <= 32'h36048BF6;
        9'd186: data <= 32'h354D8BA1;
        9'd187: data <= 32'h34968B4E;
        9'd188: data <= 32'h33DF8AFC;
        9'd189: data <= 32'h33268AAB;
        9'd190: data <= 32'h326E8A5B;
        9'd191: data <= 32'h31B58A0D;
        9'd192: data <= 32'h30FB89BF;
        9'd193: data <= 32'h30418973;
        9'd194: data <= 32'h2F878928;
        9'd195: data <= 32'h2ECC88DE;
        9'd196: data <= 32'h2E118895;
        9'd197: data <= 32'h2D55884D;
        9'd198: data <= 32'h2C998806;
        9'd199: data <= 32'h2BDC87C1;
        9'd200: data <= 32'h2B1F877C;
        9'd201: data <= 32'h2A618739;
        9'd202: data <= 32'h29A386F7;
        9'd203: data <= 32'h28E586B6;
        9'd204: data <= 32'h28268677;
        9'd205: data <= 32'h27678638;
        9'd206: data <= 32'h26A885FB;
        9'd207: data <= 32'h25E885BF;
        9'd208: data <= 32'h25288584;
        9'd209: data <= 32'h2467854A;
        9'd210: data <= 32'h23A68512;
        9'd211: data <= 32'h22E584DA;
        9'd212: data <= 32'h222384A4;
        9'd213: data <= 32'h2161846F;
        9'd214: data <= 32'h209F843B;
        9'd215: data <= 32'h1FDD8408;
        9'd216: data <= 32'h1F1A83D7;
        9'd217: data <= 32'h1E5783A7;
        9'd218: data <= 32'h1D938378;
        9'd219: data <= 32'h1CCF834A;
        9'd220: data <= 32'h1C0B831D;
        9'd221: data <= 32'h1B4782F2;
        9'd222: data <= 32'h1A8282C7;
        9'd223: data <= 32'h19BE829E;
        9'd224: data <= 32'h18F98277;
        9'd225: data <= 32'h18338250;
        9'd226: data <= 32'h176E822B;
        9'd227: data <= 32'h16A88206;
        9'd228: data <= 32'h15E281E3;
        9'd229: data <= 32'h151C81C2;
        9'd230: data <= 32'h145581A1;
        9'd231: data <= 32'h138F8182;
        9'd232: data <= 32'h12C88164;
        9'd233: data <= 32'h12018147;
        9'd234: data <= 32'h113A812B;
        9'd235: data <= 32'h10728111;
        9'd236: data <= 32'h0FAB80F7;
        9'd237: data <= 32'h0EE380DF;
        9'd238: data <= 32'h0E1C80C9;
        9'd239: data <= 32'h0D5480B3;
        9'd240: data <= 32'h0C8C809F;
        9'd241: data <= 32'h0BC4808C;
        9'd242: data <= 32'h0AFB807A;
        9'd243: data <= 32'h0A338069;
        9'd244: data <= 32'h096A805A;
        9'd245: data <= 32'h08A2804C;
        9'd246: data <= 32'h07D9803F;
        9'd247: data <= 32'h07118033;
        9'd248: data <= 32'h06488028;
        9'd249: data <= 32'h057F801F;
        9'd250: data <= 32'h04B68017;
        9'd251: data <= 32'h03ED8010;
        9'd252: data <= 32'h0324800B;
        9'd253: data <= 32'h025B8007;
        9'd254: data <= 32'h01928003;
        9'd255: data <= 32'h00C98002;
        9'd256: data <= 32'h00008001;
        9'd257: data <= 32'hFF378002;
        9'd258: data <= 32'hFE6E8003;
        9'd259: data <= 32'hFDA58007;
        9'd260: data <= 32'hFCDC800B;
        9'd261: data <= 32'hFC138010;
        9'd262: data <= 32'hFB4A8017;
        9'd263: data <= 32'hFA81801F;
        9'd264: data <= 32'hF9B88028;
        9'd265: data <= 32'hF8EF8033;
        9'd266: data <= 32'hF827803F;
        9'd267: data <= 32'hF75E804C;
        9'd268: data <= 32'hF696805A;
        9'd269: data <= 32'hF5CD8069;
        9'd270: data <= 32'hF505807A;
        9'd271: data <= 32'hF43C808C;
        9'd272: data <= 32'hF374809F;
        9'd273: data <= 32'hF2AC80B3;
        9'd274: data <= 32'hF1E480C9;
        9'd275: data <= 32'hF11D80DF;
        9'd276: data <= 32'hF05580F7;
        9'd277: data <= 32'hEF8E8111;
        9'd278: data <= 32'hEEC6812B;
        9'd279: data <= 32'hEDFF8147;
        9'd280: data <= 32'hED388164;
        9'd281: data <= 32'hEC718182;
        9'd282: data <= 32'hEBAB81A1;
        9'd283: data <= 32'hEAE481C2;
        9'd284: data <= 32'hEA1E81E3;
        9'd285: data <= 32'hE9588206;
        9'd286: data <= 32'hE892822B;
        9'd287: data <= 32'hE7CD8250;
        9'd288: data <= 32'hE7078277;
        9'd289: data <= 32'hE642829E;
        9'd290: data <= 32'hE57E82C7;
        9'd291: data <= 32'hE4B982F2;
        9'd292: data <= 32'hE3F5831D;
        9'd293: data <= 32'hE331834A;
        9'd294: data <= 32'hE26D8378;
        9'd295: data <= 32'hE1A983A7;
        9'd296: data <= 32'hE0E683D7;
        9'd297: data <= 32'hE0238408;
        9'd298: data <= 32'hDF61843B;
        9'd299: data <= 32'hDE9F846F;
        9'd300: data <= 32'hDDDD84A4;
        9'd301: data <= 32'hDD1B84DA;
        9'd302: data <= 32'hDC5A8512;
        9'd303: data <= 32'hDB99854A;
        9'd304: data <= 32'hDAD88584;
        9'd305: data <= 32'hDA1885BF;
        9'd306: data <= 32'hD95885FB;
        9'd307: data <= 32'hD8998638;
        9'd308: data <= 32'hD7DA8677;
        9'd309: data <= 32'hD71B86B6;
        9'd310: data <= 32'hD65D86F7;
        9'd311: data <= 32'hD59F8739;
        9'd312: data <= 32'hD4E1877C;
        9'd313: data <= 32'hD42487C1;
        9'd314: data <= 32'hD3678806;
        9'd315: data <= 32'hD2AB884D;
        9'd316: data <= 32'hD1EF8895;
        9'd317: data <= 32'hD13488DE;
        9'd318: data <= 32'hD0798928;
        9'd319: data <= 32'hCFBF8973;
        9'd320: data <= 32'hCF0589BF;
        9'd321: data <= 32'hCE4B8A0D;
        9'd322: data <= 32'hCD928A5B;
        9'd323: data <= 32'hCCDA8AAB;
        9'd324: data <= 32'hCC218AFC;
        9'd325: data <= 32'hCB6A8B4E;
        9'd326: data <= 32'hCAB38BA1;
        9'd327: data <= 32'hC9FC8BF6;
        9'd328: data <= 32'hC9468C4B;
        9'd329: data <= 32'hC8918CA2;
        9'd330: data <= 32'hC7DC8CF9;
        9'd331: data <= 32'hC7278D52;
        9'd332: data <= 32'hC6748DAC;
        9'd333: data <= 32'hC5C08E07;
        9'd334: data <= 32'hC50E8E63;
        9'd335: data <= 32'hC45B8EC0;
        9'd336: data <= 32'hC3AA8F1E;
        9'd337: data <= 32'hC2F98F7D;
        9'd338: data <= 32'hC2488FDE;
        9'd339: data <= 32'hC198903F;
        9'd340: data <= 32'hC0E990A2;
        9'd341: data <= 32'hC03B9105;
        9'd342: data <= 32'hBF8D916A;
        9'd343: data <= 32'hBEDF91D0;
        9'd344: data <= 32'hBE329237;
        9'd345: data <= 32'hBD86929F;
        9'd346: data <= 32'hBCDB9308;
        9'd347: data <= 32'hBC309372;
        9'd348: data <= 32'hBB8693DD;
        9'd349: data <= 32'hBADC9449;
        9'd350: data <= 32'hBA3394B6;
        9'd351: data <= 32'hB98B9524;
        9'd352: data <= 32'hB8E49593;
        9'd353: data <= 32'hB83D9603;
        9'd354: data <= 32'hB7979675;
        9'd355: data <= 32'hB6F196E7;
        9'd356: data <= 32'hB64C975A;
        9'd357: data <= 32'hB5A897CE;
        9'd358: data <= 32'hB5059844;
        9'd359: data <= 32'hB46398BA;
        9'd360: data <= 32'hB3C19931;
        9'd361: data <= 32'hB32099AA;
        9'd362: data <= 32'hB27F9A23;
        9'd363: data <= 32'hB1E09A9D;
        9'd364: data <= 32'hB1419B18;
        9'd365: data <= 32'hB0A39B94;
        9'd366: data <= 32'hB0059C12;
        9'd367: data <= 32'hAF699C90;
        9'd368: data <= 32'hAECD9D0F;
        9'd369: data <= 32'hAE329D8F;
        9'd370: data <= 32'hAD989E10;
        9'd371: data <= 32'hACFE9E92;
        9'd372: data <= 32'hAC659F15;
        9'd373: data <= 32'hABCE9F98;
        9'd374: data <= 32'hAB37A01D;
        9'd375: data <= 32'hAAA0A0A3;
        9'd376: data <= 32'hAA0BA129;
        9'd377: data <= 32'hA976A1B1;
        9'd378: data <= 32'hA8E3A239;
        9'd379: data <= 32'hA850A2C2;
        9'd380: data <= 32'hA7BEA34D;
        9'd381: data <= 32'hA72DA3D8;
        9'd382: data <= 32'hA69CA464;
        9'd383: data <= 32'hA60DA4F1;
        9'd384: data <= 32'hA57EA57E;
        9'd385: data <= 32'hA4F1A60D;
        9'd386: data <= 32'hA464A69C;
        9'd387: data <= 32'hA3D8A72D;
        9'd388: data <= 32'hA34DA7BE;
        9'd389: data <= 32'hA2C2A850;
        9'd390: data <= 32'hA239A8E3;
        9'd391: data <= 32'hA1B1A976;
        9'd392: data <= 32'hA129AA0B;
        9'd393: data <= 32'hA0A3AAA0;
        9'd394: data <= 32'hA01DAB37;
        9'd395: data <= 32'h9F98ABCE;
        9'd396: data <= 32'h9F15AC65;
        9'd397: data <= 32'h9E92ACFE;
        9'd398: data <= 32'h9E10AD98;
        9'd399: data <= 32'h9D8FAE32;
        9'd400: data <= 32'h9D0FAECD;
        9'd401: data <= 32'h9C90AF69;
        9'd402: data <= 32'h9C12B005;
        9'd403: data <= 32'h9B94B0A3;
        9'd404: data <= 32'h9B18B141;
        9'd405: data <= 32'h9A9DB1E0;
        9'd406: data <= 32'h9A23B27F;
        9'd407: data <= 32'h99AAB320;
        9'd408: data <= 32'h9931B3C1;
        9'd409: data <= 32'h98BAB463;
        9'd410: data <= 32'h9844B505;
        9'd411: data <= 32'h97CEB5A8;
        9'd412: data <= 32'h975AB64C;
        9'd413: data <= 32'h96E7B6F1;
        9'd414: data <= 32'h9675B797;
        9'd415: data <= 32'h9603B83D;
        9'd416: data <= 32'h9593B8E4;
        9'd417: data <= 32'h9524B98B;
        9'd418: data <= 32'h94B6BA33;
        9'd419: data <= 32'h9449BADC;
        9'd420: data <= 32'h93DDBB86;
        9'd421: data <= 32'h9372BC30;
        9'd422: data <= 32'h9308BCDB;
        9'd423: data <= 32'h929FBD86;
        9'd424: data <= 32'h9237BE32;
        9'd425: data <= 32'h91D0BEDF;
        9'd426: data <= 32'h916ABF8D;
        9'd427: data <= 32'h9105C03B;
        9'd428: data <= 32'h90A2C0E9;
        9'd429: data <= 32'h903FC198;
        9'd430: data <= 32'h8FDEC248;
        9'd431: data <= 32'h8F7DC2F9;
        9'd432: data <= 32'h8F1EC3AA;
        9'd433: data <= 32'h8EC0C45B;
        9'd434: data <= 32'h8E63C50E;
        9'd435: data <= 32'h8E07C5C0;
        9'd436: data <= 32'h8DACC674;
        9'd437: data <= 32'h8D52C727;
        9'd438: data <= 32'h8CF9C7DC;
        9'd439: data <= 32'h8CA2C891;
        9'd440: data <= 32'h8C4BC946;
        9'd441: data <= 32'h8BF6C9FC;
        9'd442: data <= 32'h8BA1CAB3;
        9'd443: data <= 32'h8B4ECB6A;
        9'd444: data <= 32'h8AFCCC21;
        9'd445: data <= 32'h8AABCCDA;
        9'd446: data <= 32'h8A5BCD92;
        9'd447: data <= 32'h8A0DCE4B;
        9'd448: data <= 32'h89BFCF05;
        9'd449: data <= 32'h8973CFBF;
        9'd450: data <= 32'h8928D079;
        9'd451: data <= 32'h88DED134;
        9'd452: data <= 32'h8895D1EF;
        9'd453: data <= 32'h884DD2AB;
        9'd454: data <= 32'h8806D367;
        9'd455: data <= 32'h87C1D424;
        9'd456: data <= 32'h877CD4E1;
        9'd457: data <= 32'h8739D59F;
        9'd458: data <= 32'h86F7D65D;
        9'd459: data <= 32'h86B6D71B;
        9'd460: data <= 32'h8677D7DA;
        9'd461: data <= 32'h8638D899;
        9'd462: data <= 32'h85FBD958;
        9'd463: data <= 32'h85BFDA18;
        9'd464: data <= 32'h8584DAD8;
        9'd465: data <= 32'h854ADB99;
        9'd466: data <= 32'h8512DC5A;
        9'd467: data <= 32'h84DADD1B;
        9'd468: data <= 32'h84A4DDDD;
        9'd469: data <= 32'h846FDE9F;
        9'd470: data <= 32'h843BDF61;
        9'd471: data <= 32'h8408E023;
        9'd472: data <= 32'h83D7E0E6;
        9'd473: data <= 32'h83A7E1A9;
        9'd474: data <= 32'h8378E26D;
        9'd475: data <= 32'h834AE331;
        9'd476: data <= 32'h831DE3F5;
        9'd477: data <= 32'h82F2E4B9;
        9'd478: data <= 32'h82C7E57E;
        9'd479: data <= 32'h829EE642;
        9'd480: data <= 32'h8277E707;
        9'd481: data <= 32'h8250E7CD;
        9'd482: data <= 32'h822BE892;
        9'd483: data <= 32'h8206E958;
        9'd484: data <= 32'h81E3EA1E;
        9'd485: data <= 32'h81C2EAE4;
        9'd486: data <= 32'h81A1EBAB;
        9'd487: data <= 32'h8182EC71;
        9'd488: data <= 32'h8164ED38;
        9'd489: data <= 32'h8147EDFF;
        9'd490: data <= 32'h812BEEC6;
        9'd491: data <= 32'h8111EF8E;
        9'd492: data <= 32'h80F7F055;
        9'd493: data <= 32'h80DFF11D;
        9'd494: data <= 32'h80C9F1E4;
        9'd495: data <= 32'h80B3F2AC;
        9'd496: data <= 32'h809FF374;
        9'd497: data <= 32'h808CF43C;
        9'd498: data <= 32'h807AF505;
        9'd499: data <= 32'h8069F5CD;
        9'd500: data <= 32'h805AF696;
        9'd501: data <= 32'h804CF75E;
        9'd502: data <= 32'h803FF827;
        9'd503: data <= 32'h8033F8EF;
        9'd504: data <= 32'h8028F9B8;
        9'd505: data <= 32'h801FFA81;
        9'd506: data <= 32'h8017FB4A;
        9'd507: data <= 32'h8010FC13;
        9'd508: data <= 32'h800BFCDC;
        9'd509: data <= 32'h8007FDA5;
        9'd510: data <= 32'h8003FE6E;
        9'd511: data <= 32'h8002FF37;
        default: data <= 32'h7FFF0000;
        endcase
    end
endmodule

module fft_band_rom (
    input  wire       clk,
    input  wire [8:0] addr,
    output reg  [5:0] data
);
    always @(posedge clk) begin
        case (addr)
        9'd2: data <= 6'd0;
        9'd3: data <= 6'd1;
        9'd4: data <= 6'd2;
        9'd5: data <= 6'd3;
        9'd6: data <= 6'd4;
        9'd7: data <= 6'd5;
        9'd8: data <= 6'd6;
        9'd9: data <= 6'd7;
        9'd10: data <= 6'd8;
        9'd11: data <= 6'd9;
        9'd12: data <= 6'd10;
        9'd13: data <= 6'd11;
        9'd14: data <= 6'd12;
        9'd15: data <= 6'd13;
        9'd16: data <= 6'd13;
        9'd17: data <= 6'd14;
        9'd18: data <= 6'd14;
        9'd19: data <= 6'd14;
        9'd20: data <= 6'd15;
        9'd21: data <= 6'd15;
        9'd22: data <= 6'd15;
        9'd23: data <= 6'd16;
        9'd24: data <= 6'd16;
        9'd25: data <= 6'd16;
        9'd26: data <= 6'd16;
        9'd27: data <= 6'd17;
        9'd28: data <= 6'd17;
        9'd29: data <= 6'd17;
        9'd30: data <= 6'd17;
        9'd31: data <= 6'd18;
        9'd32: data <= 6'd18;
        9'd33: data <= 6'd18;
        9'd34: data <= 6'd18;
        9'd35: data <= 6'd18;
        9'd36: data <= 6'd19;
        9'd37: data <= 6'd19;
        9'd38: data <= 6'd19;
        9'd39: data <= 6'd19;
        9'd40: data <= 6'd19;
        9'd41: data <= 6'd19;
        9'd42: data <= 6'd20;
        9'd43: data <= 6'd20;
        9'd44: data <= 6'd20;
        9'd45: data <= 6'd20;
        9'd46: data <= 6'd20;
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
        9'd245: data <= 6'd31;
        9'd246: data <= 6'd31;
        9'd247: data <= 6'd31;
        9'd248: data <= 6'd31;
        9'd249: data <= 6'd31;
        9'd250: data <= 6'd31;
        9'd251: data <= 6'd31;
        default: data <= 6'd63;
        endcase
    end
endmodule
