JIRENGOD/Digital-Synthesizer-Keyboard-with-Multiple-Voices/src/oled/oled_digit_rom.v

`timescale 1ns/1ps
// =============================================================================
// oled_digit_rom.v —— OLED 动态字符点阵（宋体 12 像素半角），由 scripts/gen_display_roms.py 自动生成，不要手改
// -----------------------------------------------------------------------------
// 地址 = {字符[3:0], 列[2:0]}（每格 8 列，字在左边 6 列）；数据 = 这一列的 12 个点（第 0 位在上）。
// 字符：0=“0”  1=“1”  2=“2”  3=“3”  4=“4”  5=“5”  6=“6”  7=“7”  8=“8”  9=“9”  10=“:”  11=“%”  12=“ ”
// 组合输出（无延迟）。
// =============================================================================
module oled_digit_rom (
    input  wire [6:0]  addr,
    output reg  [11:0] data
);

    always @(*) begin
        case (addr)
        7'd0: data = 12'h3F0;   // “0” 第 0 列
        7'd1: data = 12'h408;   // “0” 第 1 列
        7'd2: data = 12'h408;   // “0” 第 2 列
        7'd3: data = 12'h408;   // “0” 第 3 列
        7'd4: data = 12'h3F0;   // “0” 第 4 列
        7'd9: data = 12'h410;   // “1” 第 1 列
        7'd10: data = 12'h7F8;   // “1” 第 2 列
        7'd11: data = 12'h400;   // “1” 第 3 列
        7'd16: data = 12'h630;   // “2” 第 0 列
        7'd17: data = 12'h508;   // “2” 第 1 列
        7'd18: data = 12'h488;   // “2” 第 2 列
        7'd19: data = 12'h448;   // “2” 第 3 列
        7'd20: data = 12'h430;   // “2” 第 4 列
        7'd24: data = 12'h210;   // “3” 第 0 列
        7'd25: data = 12'h408;   // “3” 第 1 列
        7'd26: data = 12'h448;   // “3” 第 2 列
        7'd27: data = 12'h448;   // “3” 第 3 列
        7'd28: data = 12'h3B0;   // “3” 第 4 列
        7'd32: data = 12'h180;   // “4” 第 0 列
        7'd33: data = 12'h140;   // “4” 第 1 列
        7'd34: data = 12'h530;   // “4” 第 2 列
        7'd35: data = 12'h7F8;   // “4” 第 3 列
        7'd36: data = 12'h500;   // “4” 第 4 列
        7'd40: data = 12'h2F8;   // “5” 第 0 列
        7'd41: data = 12'h448;   // “5” 第 1 列
        7'd42: data = 12'h448;   // “5” 第 2 列
        7'd43: data = 12'h448;   // “5” 第 3 列
        7'd44: data = 12'h388;   // “5” 第 4 列
        7'd48: data = 12'h3E0;   // “6” 第 0 列
        7'd49: data = 12'h490;   // “6” 第 1 列
        7'd50: data = 12'h448;   // “6” 第 2 列
        7'd51: data = 12'h448;   // “6” 第 3 列
        7'd52: data = 12'h390;   // “6” 第 4 列
        7'd57: data = 12'h008;   // “7” 第 1 列
        7'd58: data = 12'h788;   // “7” 第 2 列
        7'd59: data = 12'h068;   // “7” 第 3 列
        7'd60: data = 12'h018;   // “7” 第 4 列
        7'd64: data = 12'h330;   // “8” 第 0 列
        7'd65: data = 12'h4C8;   // “8” 第 1 列
        7'd66: data = 12'h448;   // “8” 第 2 列
        7'd67: data = 12'h448;   // “8” 第 3 列
        7'd68: data = 12'h3B0;   // “8” 第 4 列
        7'd72: data = 12'h270;   // “9” 第 0 列
        7'd73: data = 12'h488;   // “9” 第 1 列
        7'd74: data = 12'h488;   // “9” 第 2 列
        7'd75: data = 12'h248;   // “9” 第 3 列
        7'd76: data = 12'h1F0;   // “9” 第 4 列
        7'd82: data = 12'h420;   // “:” 第 2 列
        7'd88: data = 12'h070;   // “%” 第 0 列
        7'd89: data = 12'h688;   // “%” 第 1 列
        7'd90: data = 12'h1F0;   // “%” 第 2 列
        7'd91: data = 12'h3A0;   // “%” 第 3 列
        7'd92: data = 12'h458;   // “%” 第 4 列
        7'd93: data = 12'h380;   // “%” 第 5 列
        default: data = 12'h000;
        endcase
    end

endmodule
